lolothecoder/Xplore_bmp_sensor/Xplore Pressure Sensor.pdf

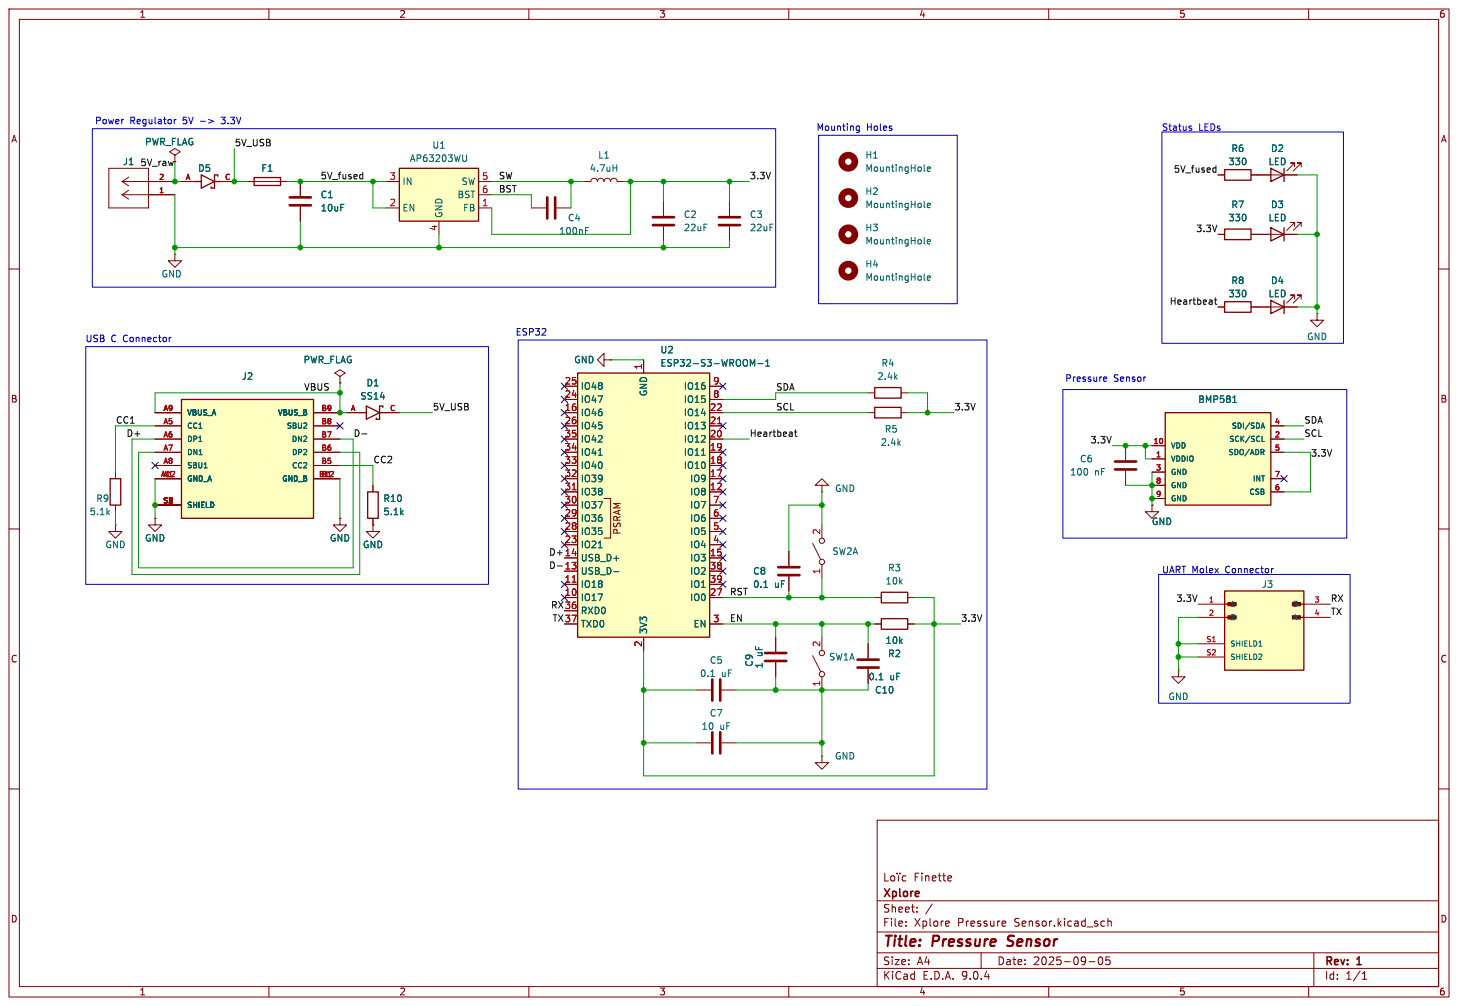
[picture p1: page 1]
